Taraved/esp32-maglev/docs/schematic.html

# Стенд магнитной левитации — монтажная схема

ESP32-S3-WROOM-1 N16R8 · силовой ключ IRLZ44N + 1N5822 · дифференциальная пара SS49E · токовый монитор INA219 · рабочий зазор 2.5 мм

Схема сгенерирована из draw_schematic.py · описание проекта — README.md · порядок сборки — ASSEMBLY.md

увеличить уменьшить вписать 100 % колесо — масштаб, перетаскивание — сдвиг

## Подключения к плате

Сигнал | Пин | Куда идёт | Почему этот пин
Датчик Холла A | GPIO 4 | средняя точка делителя A | ADC1_CH3
Датчик Холла B | GPIO 5 | средняя точка делителя B | ADC1_CH4
ШИМ на затвор | GPIO 16 | 100 Ом → затвор IRLZ44N | LEDC, свободен, не strapping
I²C SDA | GPIO 8 | SDA модуля INA219 | штатный SDA S3
I²C SCL | GPIO 9 | SCL модуля INA219 | штатный SCL S3
Метка времени | GPIO 17 | щуп осциллографа | замер времени шага регулятора
Питание датчиков | 5V | VCC обоих SS49E | SS49E требует 4.5–6 В
Логика INA219 | 3V3 | VCC модуля INA219 | логика модуля
Земля | GND | звёздная земля у истока | единая опорная точка

Ряд A определяется по первым трём контактам: 3V3 · 3V3 · RST. Ряд B начинается с GND · GND · 19. Все сигналы проекта — на ряду A.

## Что убьёт железо за секунды

- 1Полоса 1N5822 (катод) — строго к +12 В. Наоборот — диод открыт постоянно, КЗ по питанию, мгновенный пробой ключа.
- 2Выход SS49E — только через делитель 10к/10к. На выходе датчика до 5 В, вход АЦП терпит 3.3 В.
- 3Аналог — только на ADC1 (GPIO 1–10). ADC2 не работает при включённом Wi-Fi: показания замрут.
- 4GPIO 35, 36, 37 не занимать. Заняты octal PSRAM модуля N16R8.

## Занятые и опасные пины

Пины | Причина
35 · 36 · 37 | Octal PSRAM модуля N16R8
19 · 20 | Нативный USB (D− / D+)
0 · 3 · 45 · 46 | Strapping — влияют на режим загрузки
43 · 44 | UART отладочной консоли (RX/TX)
11 … 20 | ADC2 — глушится Wi-Fi (как выходы годятся)

## Звёздная земля

№ | Что сводится в точку у истока MOSFET
1 | Исток IRLZ44N
2 | «−» блока питания 12 В
3 | «−» электролитов 470 мкФ
4 | GND платы ESP32-S3
5 | Нижние выводы делителей
6 | GND датчиков Холла
7 | GND модуля INA219

Силовая и сигнальная земля идут к этой точке разными проводами. Общий провод на две функции = импульсы тока катушки попадают в опорную точку АЦП.

Схема пересобирается командой python3 draw_schematic.py — она перезаписывает schematic.png, schematic.svg и эту страницу.
