Taraved/esp32-maglev/docs/01-actuator-analysis.ru.md

# 01 — Топология поля актуатора и её следствия для управления

*[English version](01-actuator-analysis.md)*

---

## 1. Расхождение

Учебники по магнитной левитации помещают равновесный зазор на
$x_0 = 10\dots15$ мм. На этом железе — JF-XP25×20 при номинальных 12 В —
шарик из подшипниковой стали Ø10 мм притягивается только с **1–2 мм**.

Расхождение такого масштаба — не проблема настройки. Это утверждение об
актуаторе.

## 2. Причина: броневая топология

JF-XP25×20 относится к классу **удерживающих (прижимных) электромагнитов**,
а не к классу открытых соленоидов, который предполагается в литературе по
левитации.

```
   БРОНЕВОЙ (JF-XP25x20)                 ОТКРЫТЫЙ СОЛЕНОИД
      ┌───┬─────────┬───┐                   ┌──────────┐
      │ S │    N    │ S │                   │    N     │  <- полюс N
      │   │ обмотка │   │                   │ ┌──────┐ │
      │   │         │   │                   │ │обмотка││
      └───┴────┬────┴───┘                   │ └──────┘ │
         ↓ ~2 мм ↓                          │    S     │  <- полюс S
   поток замыкается на торце,               └────┬─────┘
   в воздух почти ничего не выходит         линии уходят на 15-20 мм
```

1. **Магнитная цепь.** Центральный цилиндрический керн — один полюс, внешний
   стальной стакан — противоположный.
2. **Зазор на торце.** Кольцевой зазор между ними составляет всего 1,5–2,0 мм
   и залит компаундом.
3. **Магнитное сопротивление.** Поток идёт по пути наименьшего сопротивления
   $R_m = l / (\mu_0 \mu_r S)$. Как только воздушный зазор до шарика превышает
   ~2 мм, внешний путь становится в десятки раз хуже пути «керн — стакан»
   прямо через торец.
4. **Итог.** Поток шунтируется на торце. Силовые линии почти не проникают
   дальше 2–3 мм в окружающее пространство, и на 15 мм поднимать шарик
   попросту нечем.

## 3. Почему паспортных 50 Н тоже нет

Заявленные 50 Н (5 кг) измеряются в условиях, которые эксперимент не
воспроизводит:

- **при нулевом зазоре**, по шлифованной контактной поверхности;
- на **толстой плоской плите** (≥ 5 мм) из мягкой магнитной стали, которая
  перекрывает одновременно центральный керн и внешнее кольцо, замыкая
  магнитную цепь вовсе без воздушного зазора.

Шарик Ø10 мм касается плоскости в единственной геометрической точке. Он не
замыкает магнитную цепь, а небольшая область контакта локально входит в
насыщение ($B_{sat} \approx 1{,}8$–2,0 Тл), что ограничивает достижимую силу
далеко ниже паспортной независимо от тока.

## 4. Решение и его следствия

**Принято (вариант А):** перенести рабочую точку на $x_0 = 2{,}0\dots3{,}0$ мм,
номинально **2,5 мм**.

Неустойчивый полюс зависит только от зазора:

$$s_{\text{полюс}} = \sqrt{\frac{2g}{x_0}}$$

| Зазор | Полюс | Постоянная расхождения τ | Отсчётов на τ при 1 кГц |
|---|---|---|---|
| **2,5 мм (принято)** | **88,6 рад/с** | **11,3 мс** | **11,3** |
| 15 мм (учебник) | 36,2 рад/с | 27,7 мс | 27,7 |

Объект в **2,45 раза быстрее** того, что описывает литература. Отсюда прямо
следуют четыре проектных решения, и ни одно из них не является предпочтением:

| Следствие | Почему вынужденное |
|---|---|
| Контур ≥ 1 кГц на выделенном ядре | 11,3 отсчёта на постоянную расхождения — уже тесно; Wi-Fi не должен иметь возможности сорвать такт |
| Фильтр производной ограничен τ = 2 мс | фильтрация стоит фазы, а запас по фазе при полюсе 11,3 мс невелик |
| Жёсткость стойки — требование первого порядка | 0,5 мм люфта составляют 20 % рабочего диапазона |
| Диапазон захвата будет малым | область притяжения не может превысить те несколько миллиметров, на которых поле вообще существует |

Последнюю строку стоит сказать явно: симулированный диапазон захвата равен
1,78 мм для всех проверенных регуляторов — одинаково для ПИД, MPC и сети
float32. Он ограничен **возможностями актуатора**, а не законом управления.
Единственная конфигурация, которая сужает его дальше, — квантование int8
(1,33 мм); именно поэтому эта метрика и стоит в таблице сравнения.

**В резерве (вариант Б):** стальной болт М4 длиной 6–8 мм, вкрученный в центр
торца. Он выносит полюс N вперёд относительно кольца S, разносит полюса в
пространстве и увеличивает глубину проникновения поля до 6–8 мм. Это запасной
вариант на случай, если дифференциальная пара Холла не сможет разрешать
положение на 2,5 мм; см. [`05-limitations.ru.md`](05-limitations.ru.md#риск-1).

## 5. Почему это место в портфолио, а не в сноске

Большинство студенческих проектов по левитации исходят из закона силы
открытого соленоида, покупают удерживающий электромагнит как дешёвую деталь
с внушительным паспортным усилием, а затем неделями пытаются заставить шарик
висеть на 15 мм, где поля нет. Неудачу обычно списывают на настройку
регулятора.

Приведённый анализ превращает проект из «шарик не висит» в специфицированный
объект с обоснованной рабочей точкой, вычисленным полюсом и частотой
дискретизации, выведенной из этого полюса, а не выбранной по привычке.

**Статус проверки.** Дальность притяжения 1–2 мм — наблюдение, сделанное с
реальным магнитом и шариком. Объяснение через магнитное сопротивление — анализ,
а не измерение: распределение потока не измерялось, и прямое измерение
потребовало бы гауссметра, которого в проекте нет. Закон силы и полюс
проверяются количественно протоколом P4; если измеренный полюс разойдётся
с 88,6 рад/с более чем на 30 %, это расхождение будет опубликовано как есть.
