Taraved/esp32-maglev/docs/05-limitations.ru.md

# 05 — Ограничения и риски

*[English version](05-limitations.md)*

---

## A. Допущения, перенесённые в каждое число

| Допущение | Принятое значение | Как распространяется | Снимается |
|---|---|---|---|
| Сопротивление катушки | 27 Ом (класс по даташиту) | задаёт заполнение смещения 0,5625 и $i_{max}$ | P1, сегодня |
| Индуктивность катушки | 40 мГн (класс pot-core) | задаёт $\tau_e$ = 1,48 мс и наблюдатель тока в `firmware/05` | P2 |
| Шум положения | σ = 4 мкм, квантование 2 мкм | **задаёт все значения СКО и настройку обоих регуляторов** | P3 |
| Постоянная силы $k$ | 4,01 мкН·м²/А², фиксирована по построению в $(i_0, x_0)$ | задаёт полюс и линеаризованную модель | P4 |
| Ток смещения | 0,25 А, ≈55 % от $i_{max}$ | задаёт симметричный запас управления | P4 |

Третья строка — несущая. Коэффициенты ПИД (Kp = 400, Kd = 4) подобраны сеткой
**при включённой модели шума**; без шума тот же поиск выдаёт Kp = 1600,
Kd = 12 — прекрасно выглядит на чистом сигнале и даёт 134 мкм дрожания при
реалистичном шуме АЦП, то есть разницу в 57 раз в отчётном СКО. **Если реальный
шум датчика существенно отличается от 4 мкм, оба регулятора придётся
перенастроить, и все значения СКО в таблице сравнения сдвинутся.**

## B. Риски

### Риск 1 — дифференциальная пара Холла может не разрешать положение на 2,5 мм

**Тяжесть: критическая для проекта. Вероятность: высокая.**

Дифференциальная схема опирается на то, что поле катушки действует на оба
датчика одинаково, а шарик нарушает баланс. Против неё на этом актуаторе
работают две вещи: броневая геометрия оставляет снаружи магнита очень мало
поля, которое вообще можно возмутить (§01), а собственное поле катушки в
точках установки датчиков на порядки больше вклада шарика.

Заранее зафиксированные запасные варианты, по порядку:

1. **Полюсный наконечник** (вариант Б из §01): стальной болт М4 в торце
   выносит поле на 6–8 мм в воздух, давая датчикам что измерять, и смягчает
   полюс до ~50 рад/с. Цена: один болт. Следствие: актуатор перестаёт быть
   стандартной деталью, и анализ §01 придётся переделать для изменённой
   геометрии.
2. **Оптический датчик**: ИК-светодиод и фототранзистор поперёк зазора, шарик
   перекрывает луч. Строго лучше в одном отношении — он слеп к току катушки,
   что полностью снимает проблему синфазной помехи, — и хуже в другом:
   он измеряет хорду, а не зазор, и требует собственной калибровки.

Точка принятия решения — приёмка протокола P3. Смысл в том, чтобы выбрать
запасные варианты заранее: это исключает сценарий, в котором плохой сигнал
неделями обходят настройкой вместо того, чтобы заменить.

### Риск 2 — малый диапазон захвата заложен конструктивно

Симулированный диапазон захвата равен 1,78 мм и определяется возможностями
актуатора, а не законом управления: ПИД, MPC и сеть float32 дают одно и то же
значение. На практике шарик придётся вносить рукой в окно шириной ~1,8 мм.
Это свойство стенда, а не дефект, подлежащий исправлению, и подаётся именно
так. Для повторяемости внесения будет добавлена немагнитная направляющая.

### Риск 3 — тепловой дрейф

Катушка рассеивает ~1,3 Вт в рабочей точке. Сопротивление меди растёт на
0,39 %/K, поэтому нагрев на 30 K сдвигает $R$ примерно на 12 %, вместе с ним
равновесное заполнение, и шарик уползает. Интегральная составляющая поглощает
медленный дрейф, но сама рабочая точка смещается, а значит меняется объект.
P1 измеряет эффект количественно; в модели он не учтён.

### Риск 4 — единичные экземпляры

На руках один IRLZ44N и один 1N5822 (заказано десять и пять, пришло частично),
и **всего два SS49E без единого запасного**. Одна ошибка в разводке делителя
уничтожает датчик и останавливает проект до следующей поставки.

## C. Границы применимости результата

- **Броневая топология ограничивает рабочий зазор 2–3 мм.** Результаты не
  переносятся напрямую на стенды с открытым соленоидом, где полюс в 2,45 раза
  медленнее и у квантования соответственно больше времени, чтобы ошибиться.
- **Модель объекта линеаризована вокруг единственной рабочей точки.** MPC и
  обучающие данные наследуют эту линеаризацию; поведение вдали от 2,5 мм —
  экстраполяция.
- **Гистерезис стали и нелинейность АЦП не моделировались.**
- **Ток внутри контура оценивается, а не измеряется.** INA219 требует 0,5 мс
  на чтение при периоде 1 мс, поэтому третий вход сети берётся из наблюдателя
  первого порядка, управляемого командой заполнения. Симуляция использует тот
  же наблюдатель, а не истинный ток, поэтому в этом отношении числа не
  завышены — но постоянная времени наблюдателя сама остаётся допущением, пока
  её не измерит P2, а неверная $\tau_e$ делает неверным третий вход сети.
  Шунт 0,1 Ом на ADC1 полностью снял бы зависимость и является очевидной
  следующей ревизией платы.
- **Квантование симметричное по тензору, смещения остаются float.**
  Поканальное квантование или полностью целочисленный путь смещений дали бы
  другие числа; изученная здесь схема — простейшая работающая, а не лучшая
  доступная.

## D. Что опровергло бы главный вывод

Симуляция утверждает: int8 стоит 1,33-кратной потери точности удержания, ничего
не стоит по времени успокоения и отнимает 25 % диапазона захвата.

Вывод был бы опровергнут, если бы на стенде:

- диапазоны захвата int8 и float32 совпали в пределах погрешности измерения —
  это означало бы, что симулированная потеря является артефактом области
  экстраполяции без шума, а не следствием квантования;
- или время успокоения int8 заметно деградировало — это означало бы, что
  динамика не так устойчива к ошибке коэффициентов, как предполагает симуляция.

Оба исхода публикуемы, и протокол фиксирует предсказание заранее именно для
того, чтобы любой из них можно было отличить от подгонки постфактум.
