Taraved/esp32-maglev/docs/figures/bench_raw.jpg

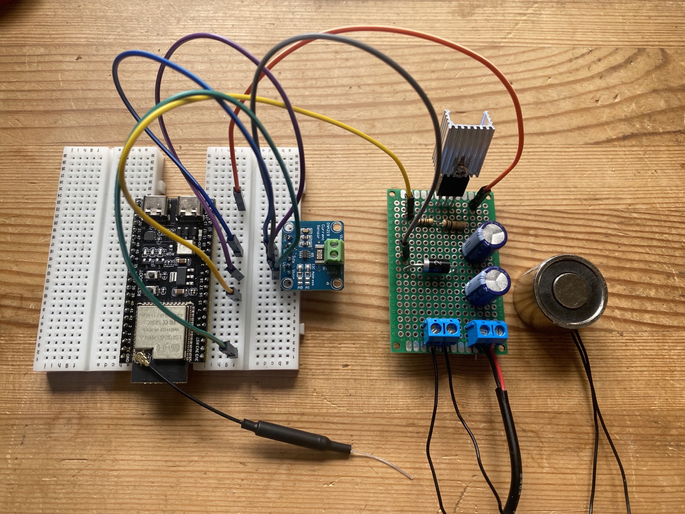
docs/figures/bench_raw.jpg
