Taraved/esp32-maglev/docs/03-measurement-protocol.ru.md

# 03 — Протокол измерений

*[English version](03-measurement-protocol.md)*

---

## Почему этот документ написан раньше данных

Каждый порог, число повторов и критерий приёмки ниже зафиксированы, пока стенд
ещё собирался, а колонка `predicted` в каждой таблице заполнена из
`analysis/simulate_controllers.py` до того, как стенд смог выдать хоть одно
число.

Порядок выбран намеренно. На объекте такой чувствительности до смешного легко
подправить постоянную фильтра, перенастроить коэффициент и в итоге отчитаться
той конфигурацией, которая случайно выглядела лучше всех, — так и не заметив,
что модель подгонялась под результат, а не проверялась им. Протокол, написанный
заранее, превращает расхождение предсказания и измерения в видимый результат,
а не в невидимую поправку.

Если предсказание окажется неверным, **предсказание остаётся в таблице.**

---

## P1 — Характеристика катушки

**Блокируется:** ничем, можно выполнить сегодня.

| Шаг | Действие |
|---|---|
| 1 | Измерить сопротивление обмотки на холодную, по возможности четырёхпроводно |
| 2 | Вычислить $i = U/R$ и сравнить с расчётными 0,44 А |
| 3 | Подать 12 В на 10 минут, фиксируя температуру корпуса ежеминутно |
| 4 | Измерить сопротивление в нагретом состоянии сразу после отключения |

| Величина | Предсказание | Измерено | Ед. |
|---|---|---|---|
| $R_{хол}$ | 27 (принято) | — | Ом |
| $R_{гор}$ через 10 мин | 30–32 (ТКС меди 0,39 %/K) | — | Ом |
| $i$ при 12 В, холодная | 0,44 | — | А |
| Прирост температуры корпуса | — | — | K |

**Приёмка:** все четыре ячейки заполнены. **Зачем:** $R$ задаёт заполнение
смещения (0,5625 по расчёту); дрейф $R$ на 15 % сдвигает рабочую точку и будет
первым кандидатом в объяснения, если шарик станет медленно уползать вниз.

## P2 — Индуктивность катушки и наблюдатель тока

**Блокируется:** P1. **Приборы:** INA219 + осциллограф на стоке.

Подать лестницу заполнения (`firmware/03_ina219_test`), записать установившийся
ток на каждой ступени, затем измерить время нарастания тока при скачке
заполнения с 0 до 50 %.

| Величина | Предсказание | Измерено | Ед. |
|---|---|---|---|
| $L$ | 40 (принято, класс pot-core) | — | мГн |
| $\tau_e = L/R$ | 1,48 | — | мс |
| Линейность $i$ от заполнения, $R^2$ | > 0,99 | — | — |

**Приёмка:** $\tau_e$ известна с точностью ±20 %. **Зачем:** `firmware/05`
оценивает ток катушки по заполнению через наблюдатель первого порядка именно
с этой постоянной, потому что INA219 требует 0,5 мс на чтение и внутри такта
1 мс работать не может. Ошибка в $\tau_e$ — это ошибка в третьем входе сети.

## P3 — Калибровка датчика положения ⭐

**Блокируется:** кронштейном датчиков. **Это ключевой эксперимент всего
проекта** — без сигнала положения контур замкнуть нельзя.

Схема и пустая таблица: [`data/calibration/hall_calibration_TEMPLATE.csv`](../data/calibration/hall_calibration_TEMPLATE.csv)

Две развёртки, потому что у дифференциальной пары две задачи и проверить надо
обе:

**Развёртка A — калибровочная кривая.** Шарик удерживается на известном зазоре
немагнитным щупом, катушка на минимальном заполнении. Зазор от 1,0 до 4,0 мм
с шагом 0,5 мм, 25 повторов на точку.

| Зазор, мм | diff (ожидаемый тренд) | diff измерено | СКО, отсчётов |
|---|---|---|---|
| 1,0 | наибольший | — | — |
| 1,5 | ↓ монотонно | — | — |
| 2,0 | ↓ | — | — |
| **2,5** | **рабочая точка** | — | — |
| 3,0 | ↓ | — | — |
| 3,5 | ↓ | — | — |
| 4,0 | наименьший | — | — |

**Развёртка B — подавление синфазной помехи.** *Шарика нет.* Заполнение
ступенями 0 → 512 → 1024 → 1536 при каждом положении датчиков. В идеале `diff`
не меняется вовсе; остаточный наклон — это и есть наводка тока катушки
в сигнал положения.

| Величина | Цель | Измерено |
|---|---|---|
| Монотонность diff(зазор) на 1–4 мм | строго монотонна | — |
| Чувствительность в $x_0$ | максимизируется положением датчиков | — |
| Синфазная наводка $\partial(\text{diff})/\partial(\text{заполнение})$ | как можно ближе к 0 | — |
| Кажущееся перемещение на полном диапазоне заполнения | < 100 мкм эквивалента | — |
| СКО шума после 16-кратной передискретизации | < 4 мкм эквивалента | — |

**Приёмка:** монотонная кривая, остаток квадратичной аппроксимации ниже 20 мкм
СКО, кажущееся перемещение от тока ниже 100 мкм эквивалента.

**Если приёмка не пройдена:** это главный технический риск проекта, и два
запасных варианта зафиксированы заранее, а не придуманы на ходу — см.
[`05-limitations.ru.md`](05-limitations.ru.md#риск-1).

Обработка: `python3 analysis/fit_calibration.py` → коэффициенты полинома,
которые вставляются в `CAL_C0..CAL_C2` прошивки.

## P4 — Идентификация объекта

**Блокируется:** P3. Ступенчато менять заполнение вокруг рабочей точки в обе
стороны, записывая отклик положения; аппроксимировать $k$ в $F = k(i/x)^2$.

| Величина | Предсказание | Измерено |
|---|---|---|
| Постоянная силы $k$ | 4,01 мкН·м²/А² (по построению) | — |
| Неустойчивый полюс из аппроксимации | 88,6 рад/с | — |
| Постоянная расхождения τ | 11,3 мс | — |

**Приёмка:** идентифицированный полюс в пределах ±30 % от предсказания. Большее
расхождение — самостоятельный результат и подаётся именно так: наиболее
вероятная причина в том, что реальный закон силы отклоняется от
обратно-квадратичного при зазоре 2,5 мм на броневом магните — а это ровно тот
режим, который [`01`](01-actuator-analysis.ru.md) и называет нестандартным.

## P5 — Сравнение регуляторов ⭐

**Блокируется:** P3, P4 и работающим ПИД. Ради этого измерения проект и
существует.

Таблица: [`data/results/controller_comparison_TEMPLATE.csv`](../data/results/controller_comparison_TEMPLATE.csv)

Одинаковые условия для всех четырёх регуляторов — одна уставка, одно
возмущение, одна сессия, чередующийся порядок для компенсации теплового дрейфа:

| Метрика | Определение | Предсказание (ПИД / MPC / f32 / int8) |
|---|---|---|
| СКО удержания | СКО зазора за 60 с установившегося режима | 2,36 / 2,61 / 2,68 / 3,55 мкм |
| Время успокоения | до ±50 мкм после калиброванного импульса | 33,1 / 17,8 / 18,0 / 17,6 мс |
| Диапазон захвата | наибольшее начальное отклонение, из которого система выходит на режим | 1,78 / 1,78 / 1,77 / 1,32 мм |
| Время шага | ширина импульса на GPIO 17 по осциллографу | — / — / — / — мкс |
| Память | байты весов | — / — / 1412 / 452 Б |

**Возмущение.** Лёгкий маятник, отпускаемый с фиксированной высоты, а не
щелчок пальцем: импульс должен быть воспроизводимым, а палец таковым не
является.

**Повторы.** 10 запусков на регулятор на метрику, результат в виде среднее ± СКО.
СКО в предсказаниях выше получены по 8 реализациям шума.

**Приёмка:** все четыре строки заполнены вместе с СКО. Главный рисунок —
наложенные переходные процессы float32 и int8.

**Предсказание, которое проверяется.** Симуляция утверждает: int8 стоит
1,33-кратной потери точности удержания, ничего не стоит по времени успокоения
и отнимает 25 % диапазона захвата. Потеря диапазона захвата — наименее
очевидный из трёх выводов и наиболее вероятно изменится под действием
реального шума и нагрева. **Если стенд его опровергнет, прав стенд, и это
опровержение и есть статья.**

## P6 — Робастность

**Блокируется:** P5. Повторить P5 с шариками Ø8 и Ø12 мм без перенастройки
регулятора. Масса меняется на +50 % и −70 %, вместе с ней сдвигаются
равновесный ток и полюс. Результат подаётся как деградация каждой метрики P5.

---

## Приборы и их пределы

| Прибор | Для чего | Известное ограничение |
|---|---|---|
| Осциллограф | форма на стоке, время шага через GPIO 17 | единственный доступный прямой замер времени шага |
| INA219 | ток катушки, P1, P2 | 0,5 мс на чтение — только вне контура |
| Мультиметр | сопротивление, напряжения делителей | четырёхпроводного режима нет: ±0,3 Ом на $R_{хол}$ |
| Щуп-мера | задание зазора в P3 | ±0,05 мм, то есть 2 % рабочего зазора — переносится в каждую точку калибровки |
| Wi-Fi-телеметрия | логирование 1 кГц в браузер | никогда не внутри задачи управления |

Допуск щупа — доминирующая систематическая погрешность P3 и, следовательно,
нижняя граница для любой величины положения в P5. Это сказано здесь, а не
обнаружено потом.
