Taraved/esp32-maglev/docs/06-faq.ru.md

# 06 — FAQ: вопросы, которые задаст рецензент

*[English version](06-faq.md)*

---

## О результате

### В чём результат, одним предложением?

В симуляции квантование нейроконтроллера в int8 стоит 1,33-кратной потери
точности удержания и **25 % диапазона захвата**, не стоя при этом ничего по
времени успокоения, — причём потеря диапазона захвата не следует из ошибки
аппроксимации в разомкнутом контуре, так что отчёт о квантовании, измеряющий
только точность слежения, этот эффект пропустит.

---

## О проекте управления

### Почему не TinyMPC, micro-OSQP или другой встраиваемый QP-солвер?

Они существуют и они быстрые — ADMM из TinyMPC, вероятно, решил бы эту задачу
(40 шагов, 3 состояния) на ESP32-S3 за несколько сотен микросекунд.

Две причины:

1. **Детерминизм.** У итеративного солвера переменное число итераций. На
   объекте с постоянной расхождения 11,3 мс и жёстким дедлайном 1 мс выход за
   бюджет во время возмущения — это упавший шарик, а худший случай наступает
   ровно тогда, когда возмущение максимально. У сети из 320 MAC время шага
   постоянно и измеримо по построению.
2. **MPC — не цель.** Это эталонная политика. Исследовательский вопрос состоит
   в том, что стоит квантование в замкнутом контуре, и для этого нужна
   политика, которую можно квантовать, — а QP-солвер квантовать нельзя.

Прямое сравнение со встраиваемым солвером — законное продолжение работы и
усилило бы её.

### Как решается радиальная устойчивость? Теорема Ирншоу запрещает пассивную устойчивость по трём осям.

Верно — активный контур управляет только вертикальной осью.

Вблизи торца броневого магнита геометрия полюсов (центральный керн, внешнее
кольцо) создаёт радиальный градиент поля, который подцентровывает шарик к оси
симметрии при малых зазорах. Это помогает, но не гарантирует устойчивости: при
большом боковом возмущении шарик может быть захвачен внешним кольцом.

Планируемая мера — механическая, а не магнитная: немагнитная направляющая
(фторопласт или акрил) вокруг рабочей области на время калибровки. Это
известное ограничение стенда, а не решённая задача, и это одна из причин,
по которым диапазон захвата вообще измеряется.

### Почему 1 кГц, а не быстрее?

Неустойчивый полюс равен 88,6 рад/с, постоянная расхождения 11,3 мс, значит
1 кГц даёт 11,3 отсчёта на постоянную времени. Этого достаточно, но без запаса.
Ограничение не в процессоре — сети int8 нужно 320 MAC, — а в измерительном
тракте: 8-кратная передискретизация АЦП и фильтр производной уже съедают
заметную долю периода, и повышение частоты без улучшения датчика означало бы
лишь более частую выборку шума.

Если протокол P3 покажет более чистый сигнал, чем предполагалось, переход на
2 кГц тривиален.

### Почему в ПИД стоит Kp = 400, а не значение, которое лучше выглядит в симуляции?

Потому что лучше выглядящее значение измерено на бесшумном сигнале. Поиск по
сетке на чистом объекте даёт Kp = 1600, Kd = 12 с отличным переходным
процессом; те же коэффициенты при реалистичной модели шума АЦП дают **134 мкм**
СКО дрожания против 2,36 мкм при Kp = 400, Kd = 4.

Разница в 57 раз в главной метрике, определённая исключительно тем, была ли
симуляция честна относительно измерительного тракта. Веса MPC подбирались тем
же способом и по той же причине: сравнивать ПИД, знающий о шуме, с MPC, не
знающим о нём, было бы подтасовкой.

---

## Об объекте

### Вихревые токи: сердечник сплошной, а не шихтованный. На 20 кГц это существенно.

Существенно. Сплошной сердечник из конструкционной стали поддерживает вихревые
токи, противодействующие изменению потока, поэтому B(t) отстаёт от i(t), и
отклик силы медленнее, чем предполагает мгновенная модель $F \propto (i/x)^2$.

Текущая модель этого не учитывает. Протокол P4 идентифицирует объект по
переходным характеристикам и спроектирован так, чтобы выявить именно это: если
измеренный полюс окажется медленнее расчётных 88,6 рад/с или появится фазовое
запаздывание, которое одна лишь электрическая постоянная объяснить не может,
в модель войдёт звено магнитного запаздывания $1/(T_{eddy}s + 1)$. Расхождение
станет результатом, а протокол фиксирует предсказание заранее именно для того,
чтобы его можно было распознать как результат.

### Справедлив ли обратно-квадратичный закон силы при зазоре 2,5 мм на броневом магните?

Это самое слабое допущение модели, и в ограничениях оно так и обозначено. Закон
выведен для простого воздушного зазора; при 2,5 мм на этой геометрии поток
частично шунтируется через торец, а локальное насыщение в области контакта
вероятно.

$k$ сейчас зафиксирована по построению — выбрана так, чтобы равновесие
выполнялось в проектной точке, — а не идентифицирована. Протокол P4
аппроксимирует её по данным. Если полученный полюс разойдётся с расчётным
более чем на 30 %, это будет опубликовано, а не исправлено задним числом.

### Почему 2,5 мм, а не больший зазор с полюсным наконечником М4?

Наконечник (вариант Б) смягчил бы полюс примерно до 50 рад/с и упростил задачу
измерения положения. Он намеренно оставлен в резерве, поскольку модифицирует
актуатор: анализ в [`01`](01-actuator-analysis.ru.md) относится к стандартной
детали, а использование стандартной детали сохраняет сопоставимость результата
с другими работами на магнитах того же класса. Если протокол P3 не пройден,
наконечник — первый запасной вариант.

---

## О сети

### Почему tanh, а не ReLU?

У ReLU производная разрывна на каждой границе активации. В контуре обратной
связи это создаёт изломы на поверхности управления, а регулятор пересекает эти
границы непрерывно, удерживая положение, — что даёт высокочастотное содержимое
в сигнале заполнения, которого гладкая активация избегает. Tanh даёт
поверхность управления класса $C^\infty$ ценой примерно 2 мкс на шаг на FPU
процессора S3.

### Почему квантование гибридное? Умножения в int8, а tanh и смещения во float.

Потому что у ESP32-S3 есть аппаратный FPU одинарной точности, а изучаемая
арифметика — та, которая доминирует: 320 умножений с накоплением в int8 против
32 вычислений tanh во float. Хранение весов в int8 — это то, что экономит
память (452 Б против 1412 Б); перевод 32 трансцендентных функций в
фиксированную точку сэкономил бы микросекунды и добавил вторую схему
квантования, о которой пришлось бы рассуждать.

Это выбор, а не необходимость, и он указан в ограничениях: полностью
целочисленный путь — с поканальными масштабами и целочисленным смещением — дал
бы другие числа. Изученная схема — простейшая работающая.

### Почему int8, а не int16?

int8 — это там, где живёт интересный отказ. int16 на этой сети был бы почти без
потерь, и у эксперимента не было бы сигнала. Если int8 окажется дороже, чем
приложение может стерпеть, int16 — очевидное следующее измерение, и конвейер
поддерживает его правкой в одну строку.

### 353 параметра — это крошечно. Сеть вообще что-то делает?

Она воспроизводит 40-шаговую QP с ограничениями с точностью 0,12 мкм по
качеству замкнутого контура. Политика, которую она имитирует, близка к
кусочно-аффинной на рабочей области — а это в точности то, что маленькая
tanh-сеть аппроксимирует хорошо. Малый размер и есть суть: вопрос в том, что
происходит на малом конце, где ошибка квантования уже не пренебрежима.

---

## О реализации

### Почему ESP32-S3, а не STM32 или Teensy?

Решающая особенность — два ядра: контур закреплён за ядром 0, а Wi-Fi-телеметрия
за ядром 1, поэтому сетевой стек не может украсть такт управления. На
одноядерном МК он рано или поздно украл бы, а на объекте с постоянной 11,3 мс
один пропущенный такт — это упавший шарик.

S3 принёс и ограничения, которые стоило задокументировать: GPIO 35/36/37 заняты
octal PSRAM, а ADC2 перестаёт работать при включённом Wi-Fi — поэтому все
аналоговые входы находятся на ADC1.

### Ток оценивается, а не измеряется. Не ослабляет ли это результат?

Это реальное ограничение, и теперь оно обрабатывается последовательно. INA219
требует 0,5 мс на чтение по I²C при периоде 1 мс, поэтому третий вход сети
берётся из наблюдателя первого порядка, управляемого командой заполнения.

**Симуляция использует тот же наблюдатель**, а не истинный ток: подача сети
истинного тока дала бы ей информацию, которой на железе нет. Постоянная времени
наблюдателя сама остаётся допущением, пока её не измерит протокол P2.

Чистое решение — аппаратное: шунт 0,1 Ом, читаемый через ADC1, дал бы быстрое
измерение тока и полностью снял зависимость. Это очевидная следующая ревизия
платы.

### Почему инференс int8 написан вручную, а не на TFLite Micro?

353 параметра не оправдывают десятки килобайт рантайма интерпретатора. Важнее
другое: время шага должно быть ограниченным и измеримым — GPIO 17 переключается
вокруг вычисления, чтобы его можно было прочитать прямо осциллографом, — а
схема квантования является предметом исследования, поэтому она должна быть на
виду, а не скрыта за конвертером фреймворка.
